adecarolis/K1FM-WSPR-TX/PDF/k1fm_wspr_tx-1.0-sch.pdf

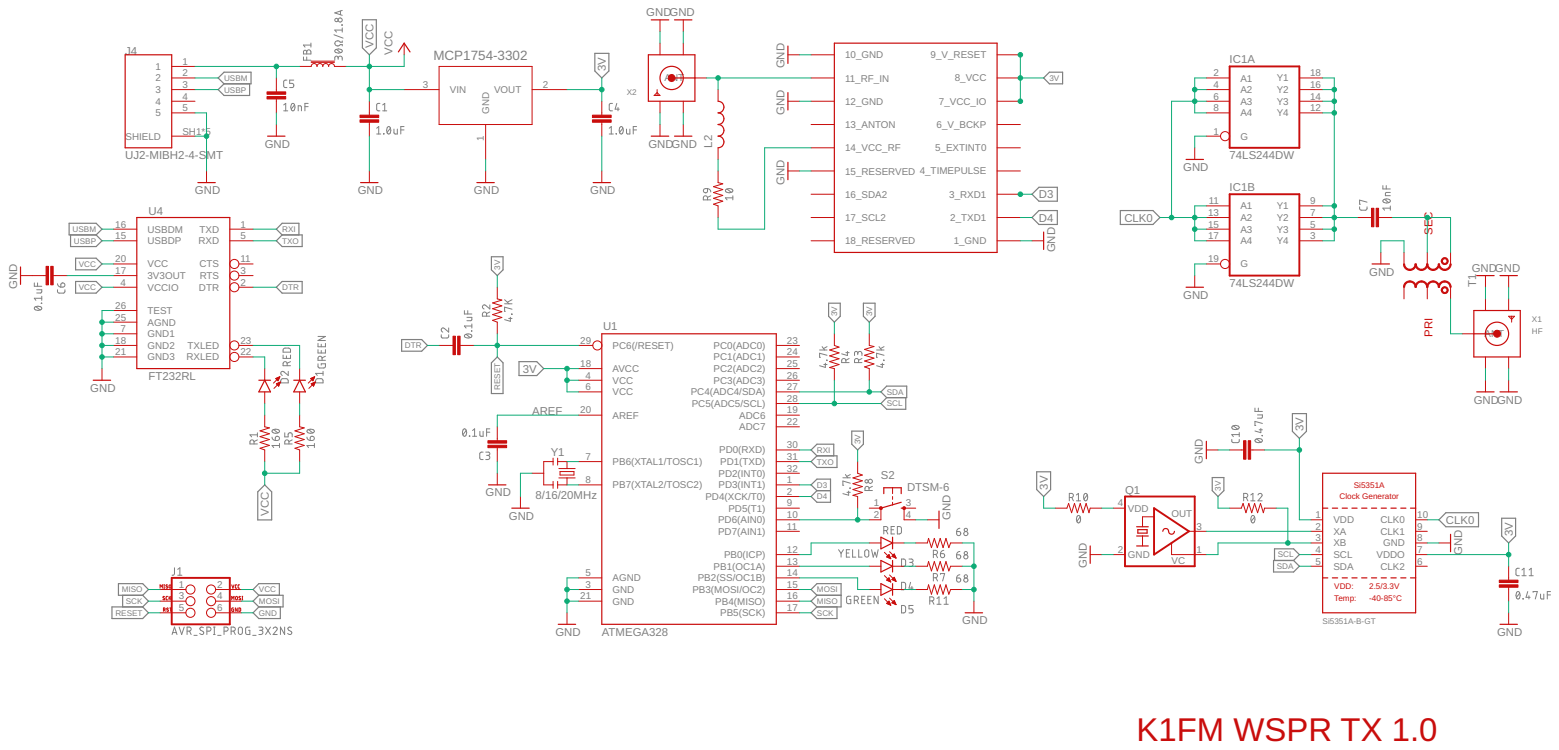
[picture p1: page 1]

GND GND GND GNDGND GND ATMEGA328 8/16/20MHz Si5351A-B-GT GND GND GND GND GNDUJ2-MIBH2-4-SMT 74LS244DW 74LS244DW GND GND GND MCP1754-3302 FT232RL GND GND GND GND GND GND GND GND GND GND VCC GND GNDGND GNDGND GND GND DTSM-6 10_GND 11_RF_IN 12_GND 13_ANTON 14_VCC_RF 15_RESERVED 16_SDA2 17_SCL2 18_RESERVED 9_V_RESET 8_VCC 7_VCC_IO 6_V_BCKP 5_EXTINT0 4_TIMEPULSE 3_RXD1 2_TXD1 1_GND PB5(SCK) 17 PB7(XTAL2/TOSC2) 8 PB6(XTAL1/TOSC1) 7 GND 3 GND 21 VCC 4 VCC 6 AGND 5 AREF 20 AVCC 18 PB4(MISO) 16 PB3(MOSI/OC2) 15 PB2(SS/OC1B) 14 PB1(OC1A) 13 PB0(ICP) 12 PD7(AIN1) 11 PD6(AIN0) 10 PD5(T1) 9 PD4(XCK/T0) 2 PD3(INT1) 1 PD2(INT0) 32 PD1(TXD) 31 PD0(RXD) 30 ADC7 22 ADC6 19 PC5(ADC5/SCL) 28 PC4(ADC4/SDA) 27 PC3(ADC3) 26 PC2(ADC2) 25 PC1(ADC1) 24 PC0(ADC0) 23 PC6(/RESET) 29 U1 Y1 VDD 1 XA 2 XB 3 SCL 4 SDA 5 CLK2 6 VDDO 7 GND 8 CLK1 9 CLK0 10 1 1 2 2 3 3 4 4 SHIELD SH1*5 5 5 J4 T1 1 2 3 4 5 6 G 1 A1 2 A2 4 A3 6 A4 8 Y4 12 Y3 14 Y2 16 Y1 18 IC1AG 19 A1 11 A2 13 A3 15 A4 17 Y4 3 Y3 5 Y2 7 Y1 9 IC1B OUT GND VDD VC 24 31 Q1 GND 1 VOUT 2 VIN 3 3V3OUT 17 USBDM 16 USBDP 15 GND1 7 GND2 18 GND3 21 TXD 1 RXD 5 VCCIO 4 AGND 25 TEST 26 VCC 20 TXLED 23 RXLED 22 RTS 3 CTS 11 DTR 2 U4 ANT X1HF ANT X2 L2 1 3 2 4 S2 GND D3 D3 D4 D43V 3V 3V3V 3V 3V 3V 3V 3V 3V3V MISO MISO MOSI MOSI SCK SCK AREF RESET RESET DTR DTR TXO TXO RXI RXI SDA SDA SCL SCL CLK0 CLK0 USBM USBM USBP USBP VCC VCC VCC VCC VCC K1FM WSPR TX 1.0 Si5351A Clock Generator VDD: 2.5/3.3V Temp: -40-85°C PRI SEC
