adecarolis/K1FM-WSPR-TX/Eagle/k1fm_wspr_tx-1.1.pdf

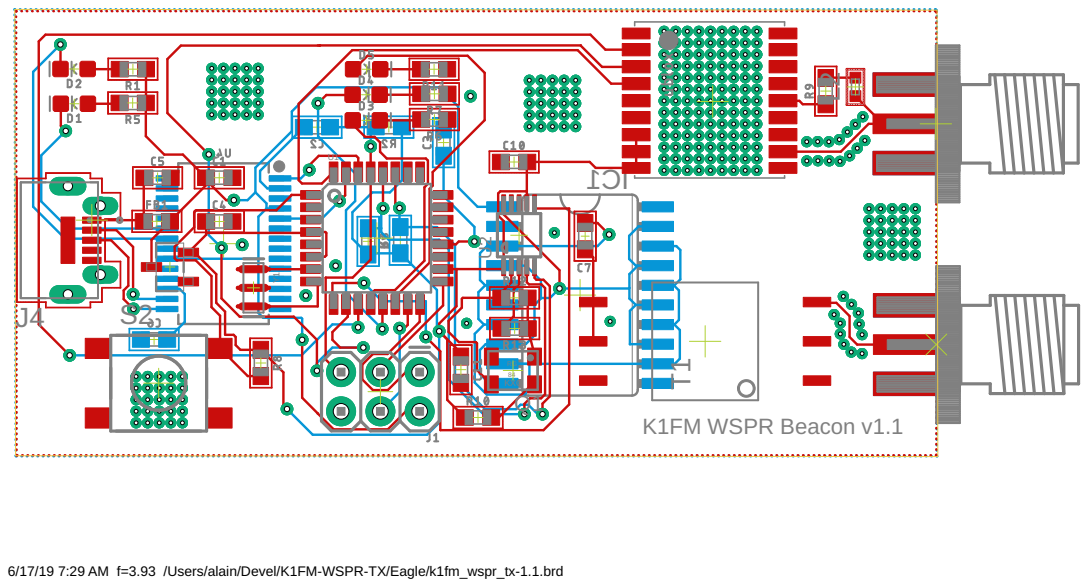
[picture p2: page 1]

6/17/19 7:29 AM f=3.93 /Users/alain/Devel/K1FM-WSPR-TX/Eagle/k1fm_wspr_tx-1.1.brd
