adecarolis/K1FM-WSPR-TX/PDF/k1fm_wspr_tx-1.1-brd.pdf

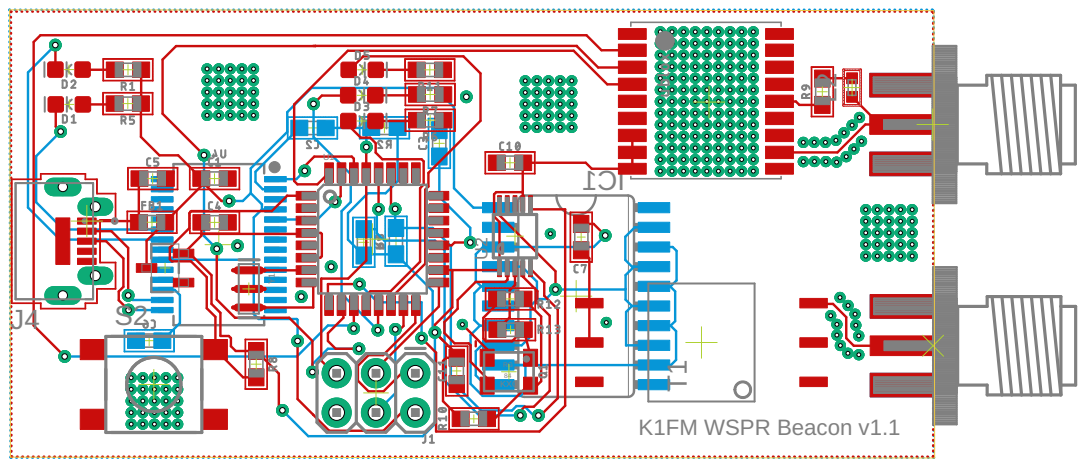
[picture p3: page 1]

1 CI KXO RG84 K1FM WSPR Beacon v1.1 J4 T1 U1 U2 Y1 L2 S2
