adecarolis/K1FM-WSPR-TX/PDF/k1fm_wspr_tx-1.1-sch.pdf

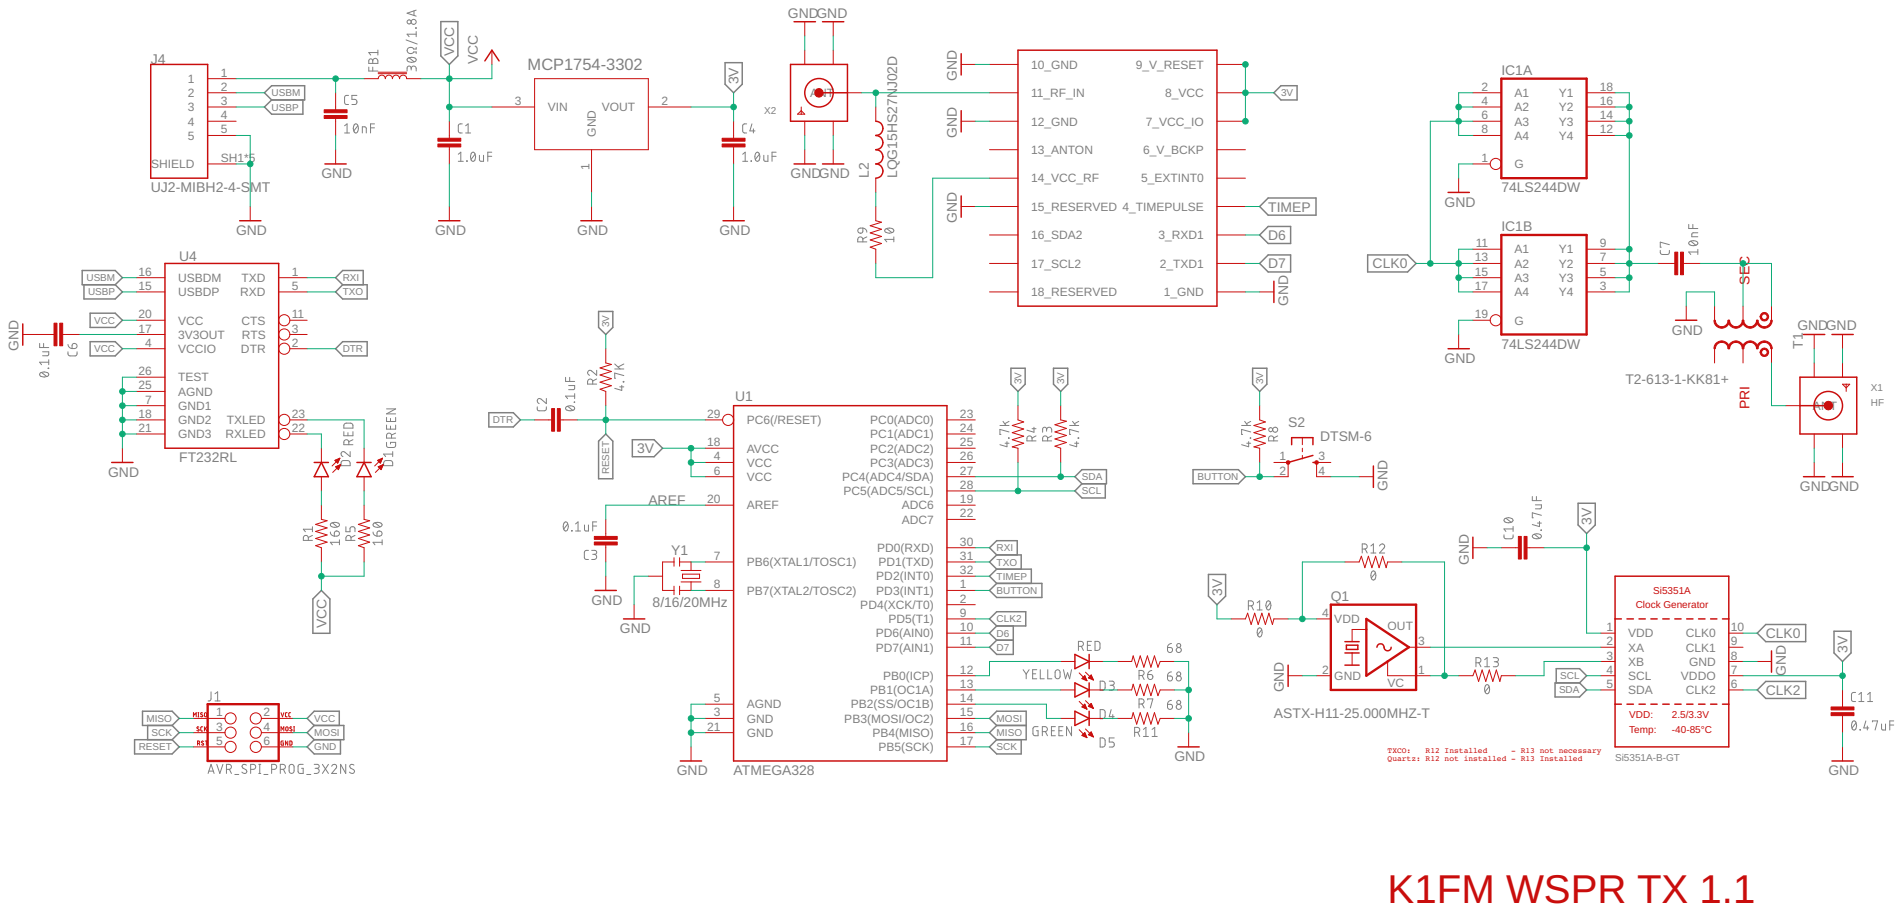
[picture p4: page 1]

Quartz: R12 not installed - R13 Installed
