adecarolis/K1FM-WSPR-TX/PDF/k1fm_wspr_tx-1.0-brd.pdf

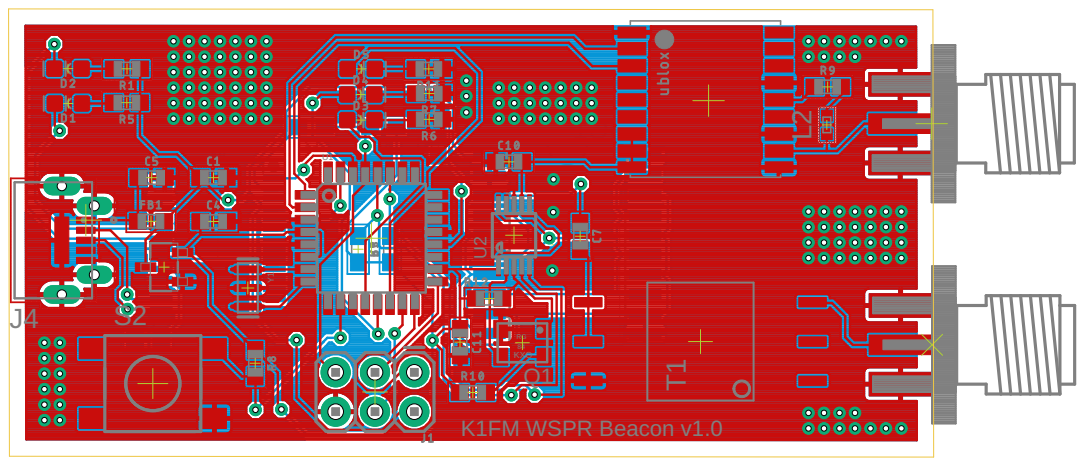
[picture p5: page 1]

1 CI KXO RG84 K1FM WSPR Beacon v1.0 J4 T1 U1 U2 Y1 Q1 L2 S2
