adecarolis/K1FM-WSPR-TX/Eagle/k1fm_wspr_tx-1.1.brd

## EAGLE design Eagle/k1fm_wspr_tx-1.1.brd (2019-07-13)

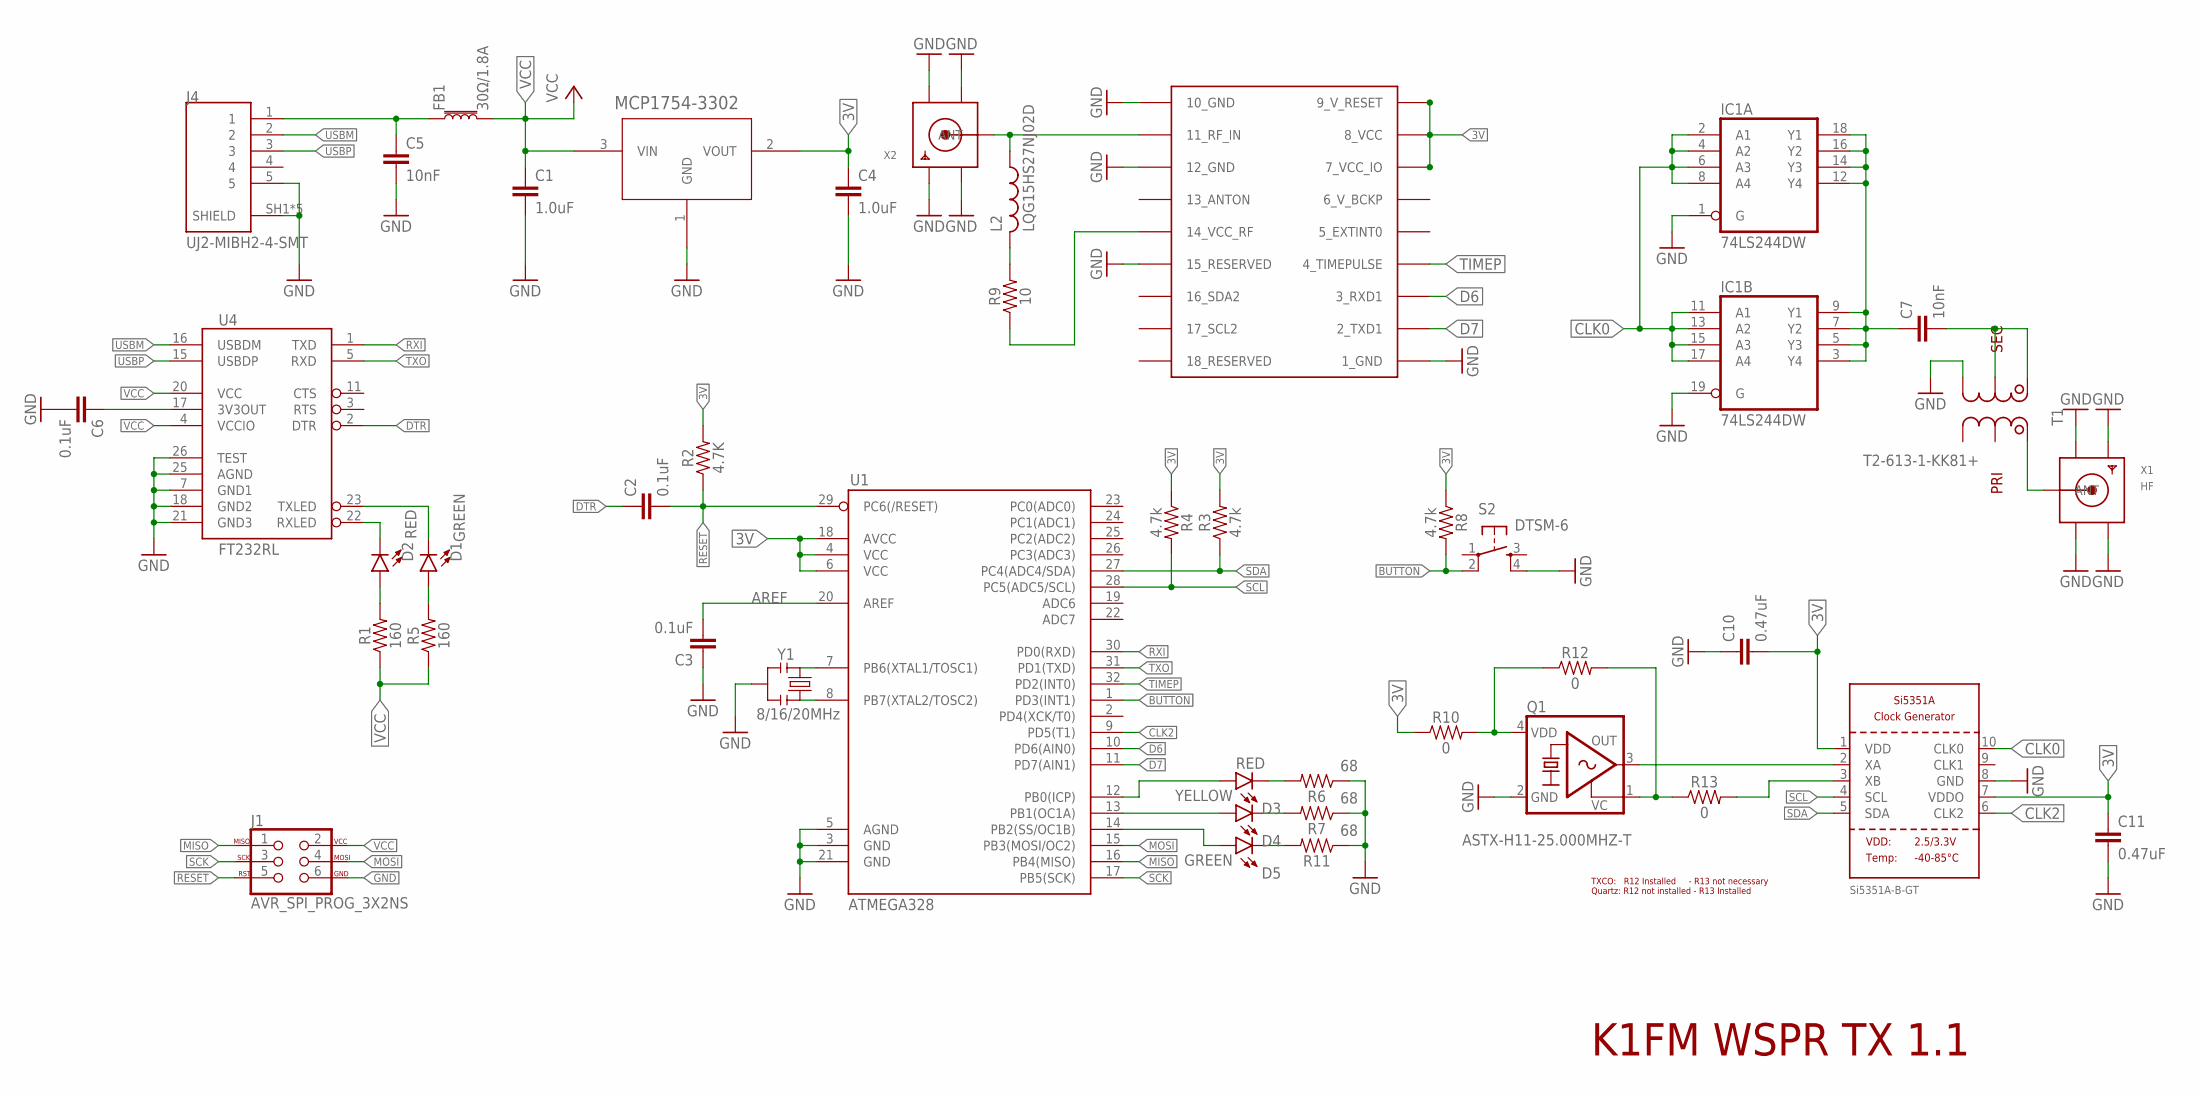
[picture p6: schematic k1fm_wspr_tx-1.1.sch]

Parts:
C1, C4: 1.0uF; 0603
C2, C3, C6: 0.1uF; 0603
C5, C7: 10nF; 0603
C10, C11: 0.47uF; 0603
D1, D5: GREEN; LED-0603
D2, D3: RED; LED-0603
D4: YELLOW; LED-0603
FB1: 30Ω/1.8A; 0603
GPS1: UBLOX_MAX
IC1: 74LS244DW; SO20W
J1: AVR_SPI_PROG_3X2NS; 2X3-NS
J4: UJ2-MIBH2-4-SMT; CUI_UJ2-MIBH2-4-SMT
L2: LQG15HS27NJ02D; RESC0402_M
Q1: ASTX-H11-25.000MHZ-T; 3.2X2.5_KXO-84
R1, R5: 160; 0603
R2: 4.7K; 0603
R3, R4, R8: 4.7k; 0603
R6, R7, R11: 68; 0603
R9: 10; 0603
R10, R12, R13: 0; 0603
S2: DTSM-6
T1: T2-613-1-KK81+; KK81
U1: ATMEGA328; TQFP32-08
U2: Si5351A-B-GT; MSOP10
U3: MCP1754X-XXXXX/C; SOT-23A_MC
U4: FT232RL; SSOP28DB
X1: HF; SMA_EDGELAUNCH
X2: SMACONNECTOR_EDGE; SMA_EDGELAUNCH
Y1: 8/16/20MHz; RESONATOR-SMD-1:1

Connections:
3V: C4.1, C10.2, C11.1, GPS1.7_VCC_IO, GPS1.8_VCC, GPS1.9_V_RESET, R2.2, R3.2, R4.1, R8.1, R10.1, U1.4 (VCC), U1.6 (VCC), U1.18 (AVCC), U2.1 (VDD), U2.7 (VDDO), U3.2 (VOUT)
AREF: C3.2, U1.20 (AREF)
BUTTON: R8.2, S2.2, U1.1 (PD3(INT1))
CLK0: IC1.2 (A1), IC1.4 (A2), IC1.6 (A3), IC1.8 (A4), IC1.11 (A1), IC1.13 (A2), IC1.15 (A3), IC1.17 (A4), U2.10 (CLK0)
CLK2: U1.9 (PD5(T1)), U2.6 (CLK2)
D6: GPS1.3_RXD1, U1.10 (PD6(AIN0))
D7: GPS1.2_TXD1, U1.11 (PD7(AIN1))
DTR: C2.1, U4.2 (DTR)
GND: C1.2, C3.1, C4.2, C5.2, C6.2, C10.1, C11.2, GPS1.1_GND, GPS1.10_GND, GPS1.12_GND, GPS1.15_RESERVED, IC1.1 (G), IC1.10 (GND), IC1.19 (G), J1.6, J4.5, J4.SH1 (SHIELD), J4.SH2 (SHIELD), J4.SH3 (SHIELD), J4.SH4 (SHIELD), J4.SH5 (SHIELD), Q1.2 (GND), R6.1, R7.1, R11.1, S2.4, T1.1 (S2), U1.3 (GND), U1.5 (AGND), U1.21 (GND), U2.8 (GND), U3.1 (GND), U4.7 (GND1), U4.18 (GND2), U4.21 (GND3), U4.25 (AGND), U4.26 (TEST), X1.GND@1 (GND4), X1.GND@2 (GND3), X1.GND@3 (GND2), X1.GND@4 (GND1), X2.GND@1 (GND4), X2.GND@2 (GND3), X2.GND@3 (GND2), X2.GND@4 (GND1), Y1.2
MISO: J1.1, U1.16 (PB4(MISO))
MOSI: J1.4, U1.15 (PB3(MOSI/OC2))
unnamed: GPS1.11_RF_IN, L2.1, X2.P (ANT)
unnamed: D2.C, U4.22 (RXLED)
unnamed: C7.1, IC1.3 (Y4), IC1.5 (Y3), IC1.7 (Y2), IC1.9 (Y1), IC1.12 (Y4), IC1.14 (Y3), IC1.16 (Y2), IC1.18 (Y1)
unnamed: T1.4 (P1), X1.P (ANT)
unnamed: C7.2, T1.2 (ST), T1.3 (S1)
unnamed: Q1.3 (OUT), U2.2 (XA)
unnamed: D1.C, U4.23 (TXLED)
unnamed: C5.1, FB1.1, J4.1
unnamed: D2.A, R1.2
unnamed: D1.A, R5.2
unnamed: D3.A, U1.12 (PB0(ICP))
unnamed: D4.A, U1.13 (PB1(OC1A))
unnamed: D3.C, R6.2
unnamed: C6.1, U4.17 (3V3OUT)
unnamed: D4.C, R7.2
unnamed: Q1.4 (VDD), R10.2, R12.1
unnamed: L2.2, R9.2
unnamed: GPS1.14_VCC_RF, R9.1
unnamed: D5.A, U1.14 (PB2(SS/OC1B))
unnamed: D5.C, R11.2
unnamed: R13.2, U2.3 (XB)
unnamed: Q1.1 (VC), R12.2, R13.1
unnamed: U1.8 (PB7(XTAL2/TOSC2)), Y1.3
unnamed: U1.7 (PB6(XTAL1/TOSC1)), Y1.1
RESET: C2.2, J1.5, R2.1, U1.29 (PC6(/RESET))
RXI: U1.30 (PD0(RXD)), U4.1 (TXD)
SCK: J1.3, U1.17 (PB5(SCK))
SCL: R4.2, U1.28 (PC5(ADC5/SCL)), U2.4 (SCL)
SDA: R3.1, U1.27 (PC4(ADC4/SDA)), U2.5 (SDA)
TIMEP: GPS1.4_TIMEPULSE, U1.32 (PD2(INT0))
TXO: U1.31 (PD1(TXD)), U4.5 (RXD)
USBM: J4.2, U4.16 (USBDM)
USBP: J4.3, U4.15 (USBDP)
VCC: C1.1, FB1.2, IC1.20 (VCC), J1.2, R1.1, R5.1, U3.3 (VIN), U4.4 (VCCIO), U4.20 (VCC)

Notes on the sheet:
K1FM WSPR TX 1.1
TXCO: R12 Installed - R13 not necessary Quartz: R12 not installed - R13 Installed

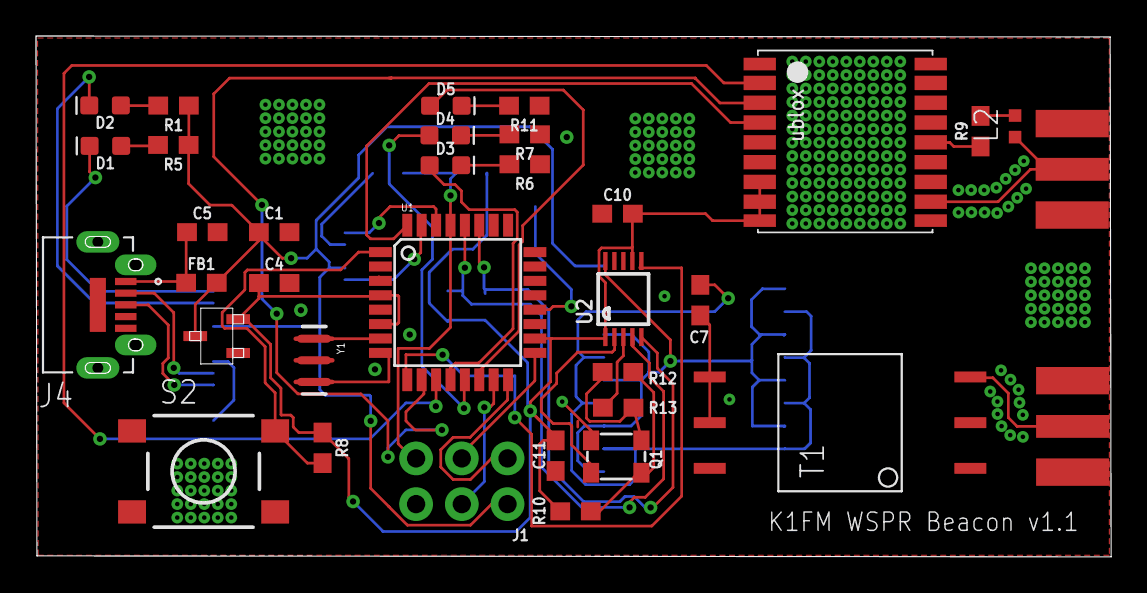
[picture p7: board k1fm_wspr_tx-1.1.brd from above]

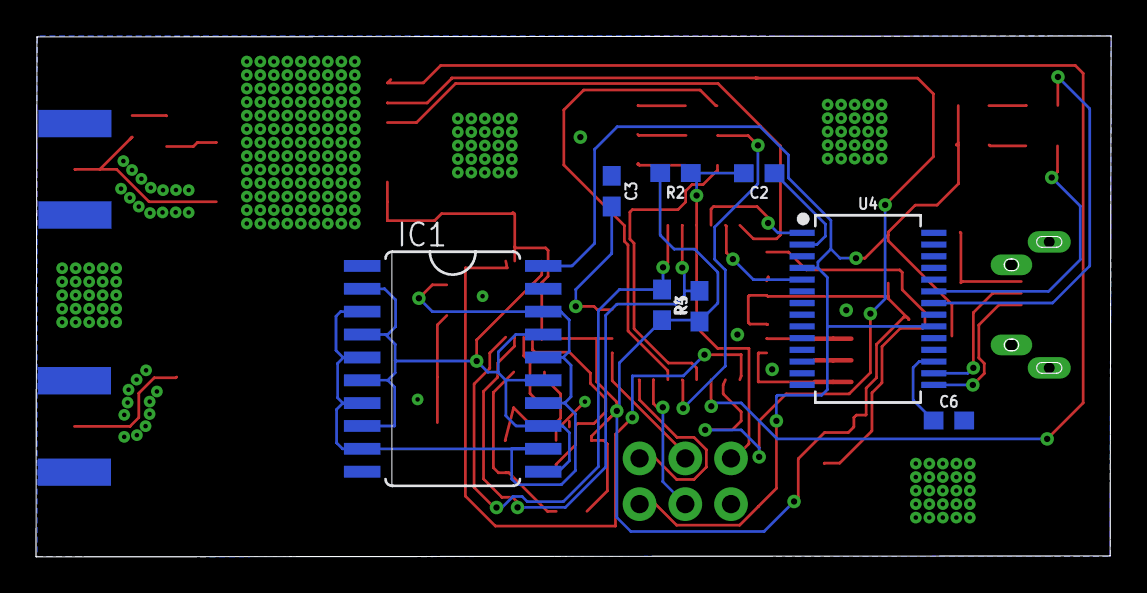
[picture p8: board k1fm_wspr_tx-1.1.brd from below]

Board: 2 copper layers, 59.7 x 28.9 mm, 43 parts (8 on the bottom side), 45 nets.
