adecarolis/K1FM-WSPR-TX/(commit log)

2019-07-13 Add board v1.0
    [k1fm_wspr_tx-1.0.brd, k1fm_wspr_tx-1.0.sch]
2019-07-13 Add board v1.1
    [k1fm_wspr_tx-1.1.brd, k1fm_wspr_tx-1.1.sch]
